DTA-Wijesekara/Foot-relaxing-machine/videos & images/WhatsApp Image 2023-10-02 at 22.15.58_83409f4f.jpg

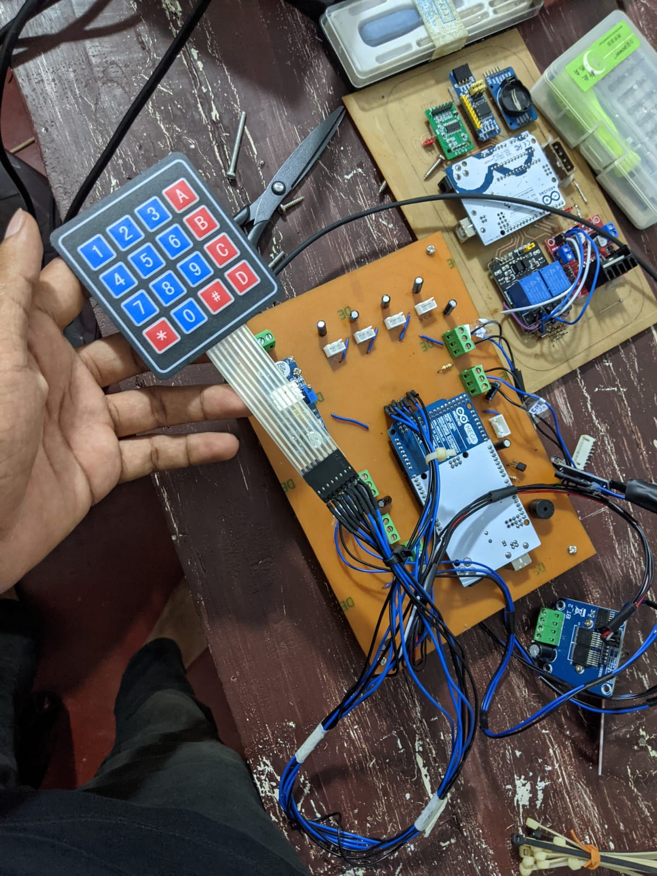
videos & images/WhatsApp Image 2023-10-02 at 22.15.58_83409f4f.jpg
