DTA-Wijesekara/Foot-relaxing-machine/pcb/WhatsApp Image 2023-10-03 at 07.08.09_02bc1081.jpg

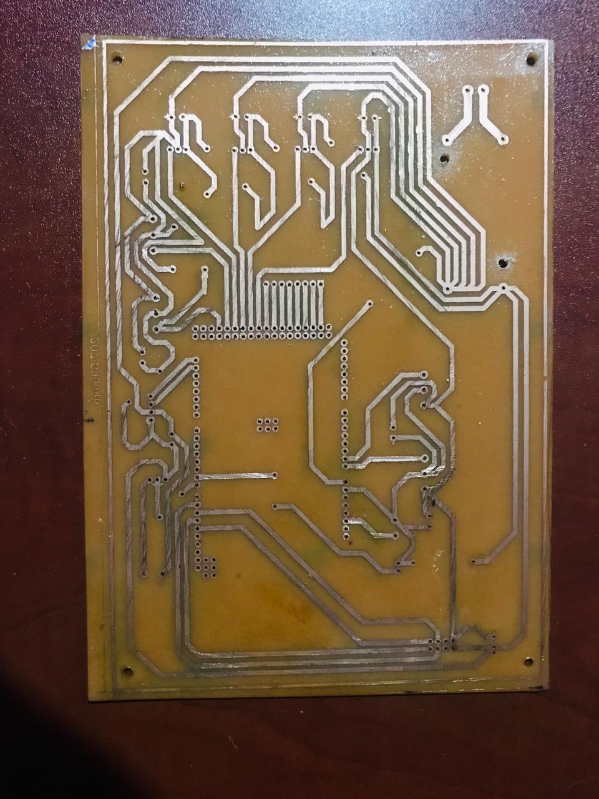
pcb/WhatsApp Image 2023-10-03 at 07.08.09_02bc1081.jpg
