DTA-Wijesekara/Foot-relaxing-machine/README.md

# Foot-relaxing-machine
foot relaxing machine including heating fan and pain releaf spray .using arduino mega.
