DTA-Wijesekara/Foot-relaxing-machine/videos & images/WhatsApp Image 2023-07-20 at 23.15.07_3dc6559c.jpg

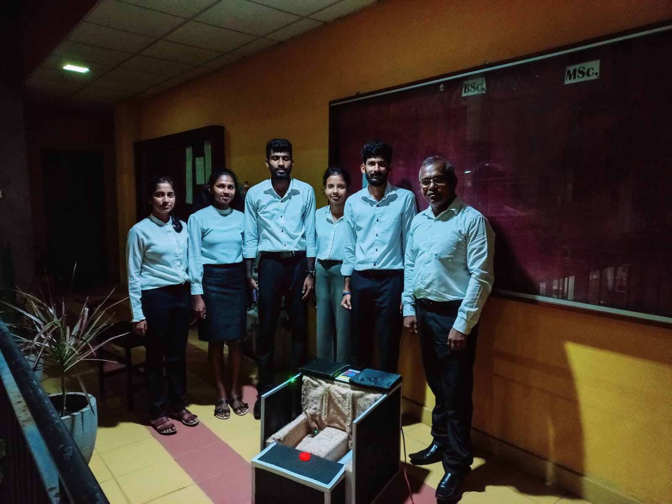
videos & images/WhatsApp Image 2023-07-20 at 23.15.07_3dc6559c.jpg
