DTA-Wijesekara/Foot-relaxing-machine/videos & images/WhatsApp Image 2023-07-28 at 13.01.50_f6cb82b2.jpg

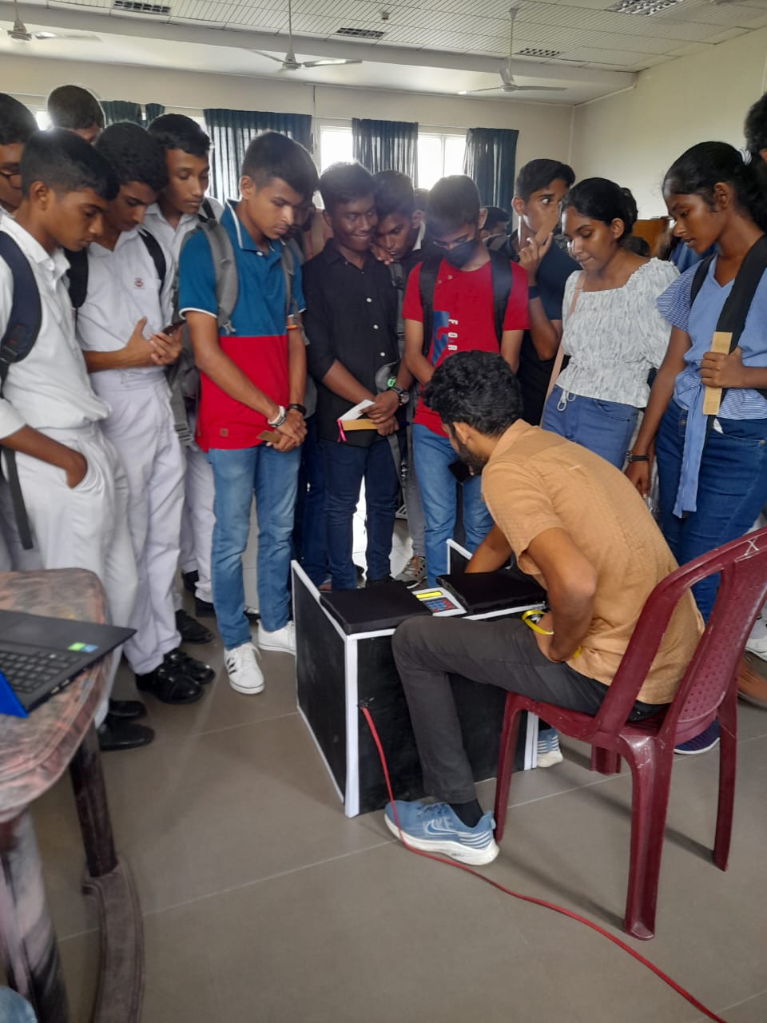
videos & images/WhatsApp Image 2023-07-28 at 13.01.50_f6cb82b2.jpg
