DTA-Wijesekara/Foot-relaxing-machine/videos & images/WhatsApp Image 2023-10-02 at 22.08.28_6fc530b1.jpg

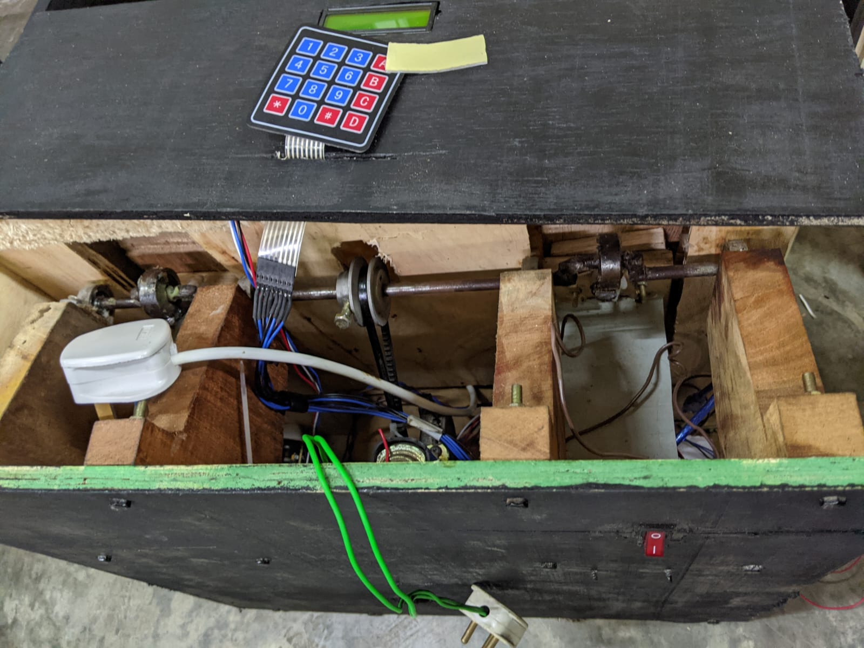
videos & images/WhatsApp Image 2023-10-02 at 22.08.28_6fc530b1.jpg
