DTA-Wijesekara/Foot-relaxing-machine/videos & images/WhatsApp Image 2023-10-02 at 22.15.25_cdd72bb3.jpg

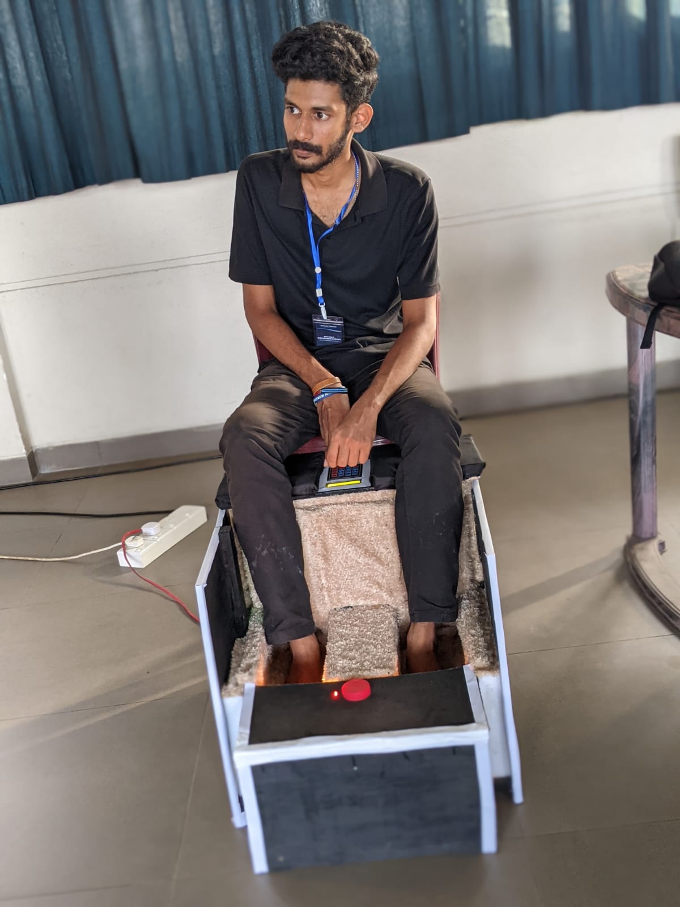
videos & images/WhatsApp Image 2023-10-02 at 22.15.25_cdd72bb3.jpg
