DTA-Wijesekara/Foot-relaxing-machine/videos & images/WhatsApp Image 2023-10-02 at 22.15.59_a593094e.jpg

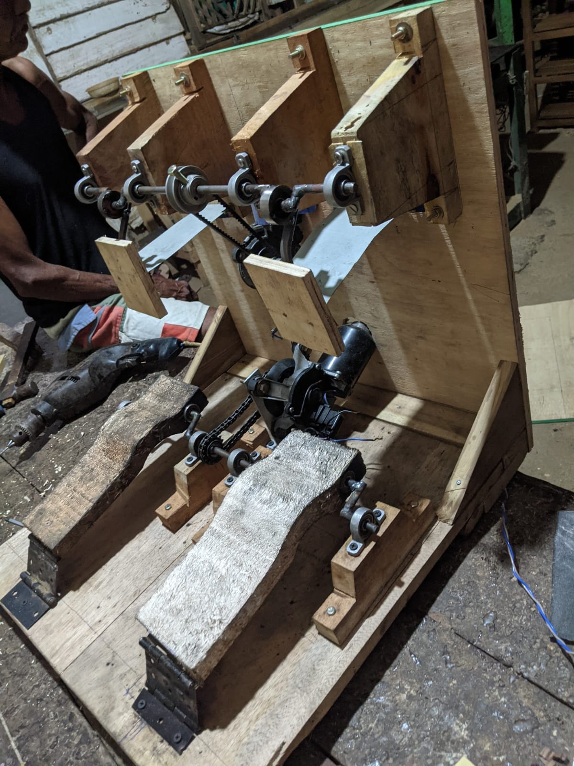
videos & images/WhatsApp Image 2023-10-02 at 22.15.59_a593094e.jpg
